infochemistry-ai/afm-lbl-data-driven-backend/(commit log)

2026-05-29 feat(db): add ORM models (experiment, sample, layer, scan, feature, export, polyelectrolyte)
2026-05-30 feat(features): add sample-level polyelectrolyte extractor
2026-05-30 feat(api): add experiments and samples endpoints
2026-05-30 feat(export): add dataset export service, task, and endpoints
    Build feature matrix joining scans/samples/layers/features, write to
    parquet or csv via storage backend, and expose via POST /exports/dataset,
    GET /exports/{id}, and GET /exports/{id}/download endpoints with a
    background Celery task (build_export_task).
2026-05-30 test(e2e): full flow — experiment, sample, scan, features, export
2026-05-30 fix(ingestion): delete storage file when scan insert fails
2026-05-30 fix(features): correct pixel pitch to extent / (N-1); bump iso25178 and metadata to v0.2.0
2026-05-30 feat(api): add GET /samples/{id}/features endpoint
2026-05-30 feat(features): add pe_sequence_kmer extractor (bigrams/trigrams of layer types and charges)
2026-05-30 test: assert stage 2 extractors and columns in pipeline/e2e tests
2026-05-30 docs: document stage 2 extractors and vendored lacunarity
2026-05-31 chore: pin python version
2026-06-10 Add files via upload
    Designed 3D models of the auxiliary device and holders in .STEP format.
    [100_ml_glass_bottle.STEP, Petri_dish.STEP, Petri_dish_holder.STEP, Petri_dish_output_stack.STEP, Plates_holder.STEP, Tweezers_holder.STEP, Tweezers_pusher_holder.STEP]
